adafruit/Adafruit-bq25185-with-3.3V-Buck-PCB/Adafruit bq25185 with 3.3V Output.brd

## EAGLE design Adafruit bq25185 with 3.3V Output.brd (2024-11-22)

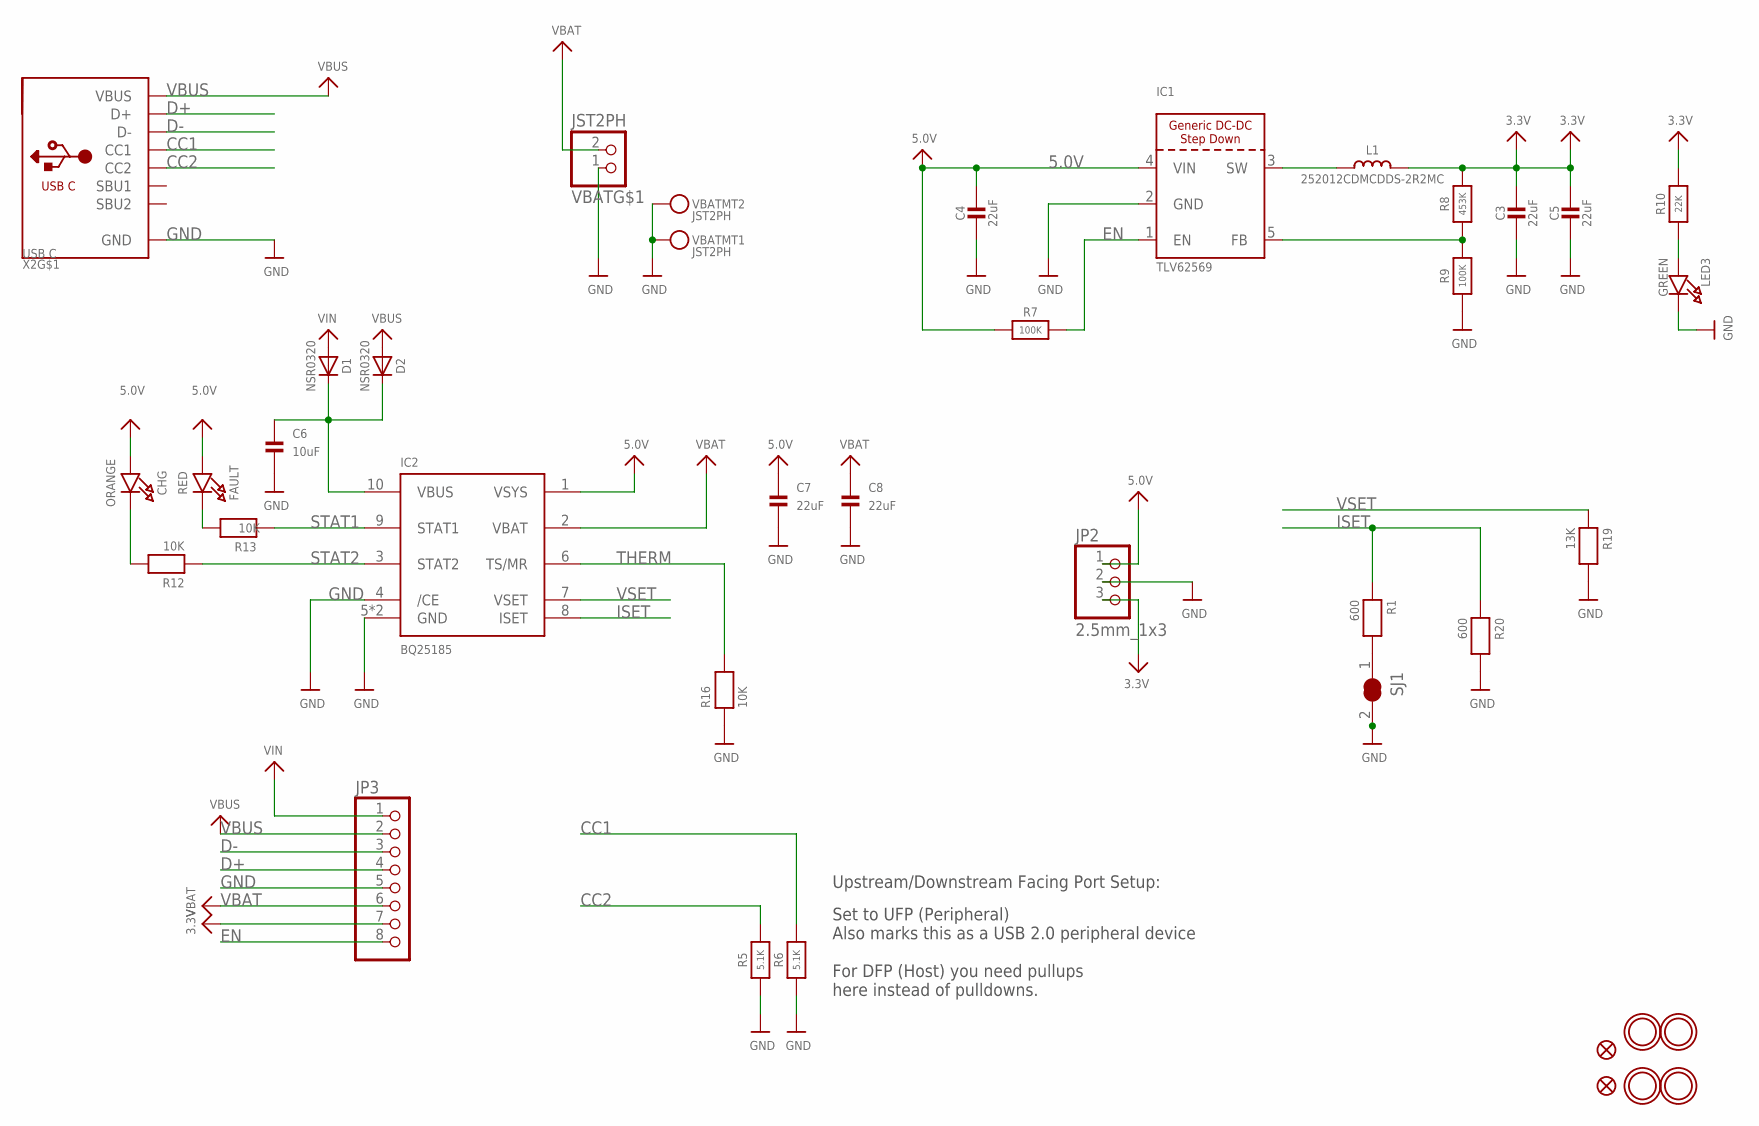
[picture p2: schematic Adafruit bq25185 with 3.3V Output.sch]

Parts:
C3, C4, C5, C7, C8: 22uF; 0805-NO
C6: 10uF; 0805-NO
CHG: ORANGE; CHIPLED_0603_NOOUTLINE
D1, D2: NSR0320; SOD-323_MINI
FAULT: RED; CHIPLED_0603_NOOUTLINE
FID1, FID2: FIDUCIAL_0.5MM
IC1: TLV62569; SOT23-5
IC2: BQ25185; WSON10
JP2: 2.5mm_1x3; 1X03_2.54MMTERMINAL
JP3: HEADER-1X870MIL; 1X08_ROUND_70
L1: 252012CDMCDDS-2R2MC; INDUCTOR_TAIYOYUDEN_NRH2412T
LED3: GREEN; CHIPLED_0603_NOOUTLINE
R1, R20: 600; _0402NO
R5, R6: 5.1K; _0402NO
R7, R9: 100K; _0402NO
R8: 453K; _0402NO
R10: 22K; _0402NO
R12, R13, R16: 10K; _0402NO
R19: 13K; _0402NO
SJ1: SOLDERJUMPER_CLOSED; SOLDERJUMPER_CLOSEDWIRE
U$9, U$10, U$11, U$12: MOUNTINGHOLE2.5; MOUNTINGHOLE_2.5_PLATED
VBAT: JST2PH; JSTPH2_BATT
X2: USB C; USB_C_CUSB31-CFM2AX-01-X

Connections:
3.3V: C3.1, C5.1, JP2.3, JP3.7, L1.2, R8.2, R10.2
5.0V: C4.1, C7.1, CHG.A, FAULT.A, IC1.4 (VIN), IC2.1 (VSYS), JP2.1, R7.1
CC1: R6.2, X2.A5 (CC1)
CC2: R5.2, X2.B5 (CC2)
D+: JP3.4, X2.A6 (D+), X2.B6 (D+)
D-: JP3.3, X2.A7 (D-), X2.B7 (D-)
EN: IC1.1 (EN), JP3.8, R7.2
FB: IC1.5 (FB), R8.1, R9.2
GND: C3.2, C4.2, C5.2, C6.2, C7.2, C8.2, IC1.2 (GND), IC2.4 (/CE), IC2.5 (GND), IC2.PAD (GND), JP2.2, JP3.5, LED3.C, R5.1, R6.1, R9.1, R16.1, R19.2, R20.2, SJ1.2, VBAT.1, VBAT.NC1, VBAT.NC2, X2.A1B12 (GND), X2.B1A12 (GND)
ISET: IC2.8 (ISET), R1.1, R20.1
unnamed: R1.2, SJ1.1
unnamed: C6.1, D1.C, D2.C, IC2.10 (VBUS)
unnamed: IC1.3 (SW), L1.1
unnamed: CHG.C, R12.2
unnamed: LED3.A, R10.1
unnamed: FAULT.C, R13.2
STAT1: IC2.9 (STAT1), R13.1
STAT2: IC2.3 (STAT2), R12.1
THERM: IC2.6 (TS/MR), R16.2
VBAT: C8.1, IC2.2 (VBAT), JP3.6, VBAT.2
VBUS: D2.A, JP3.2, X2.A4B9 (VBUS), X2.B4A9 (VBUS)
VIN: D1.A, JP3.1
VSET: IC2.7 (VSET), R19.1

Notes on the sheet:
Set to UFP (Peripheral) Also marks this as a USB 2.0 peripheral device For DFP (Host) you need pullups here instead of pulldowns.
Upstream/Downstream Facing Port Setup:

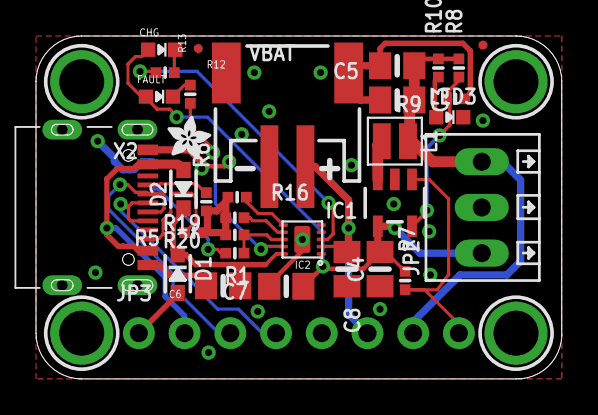
[picture p3: board Adafruit bq25185 with 3.3V Output.brd from above]

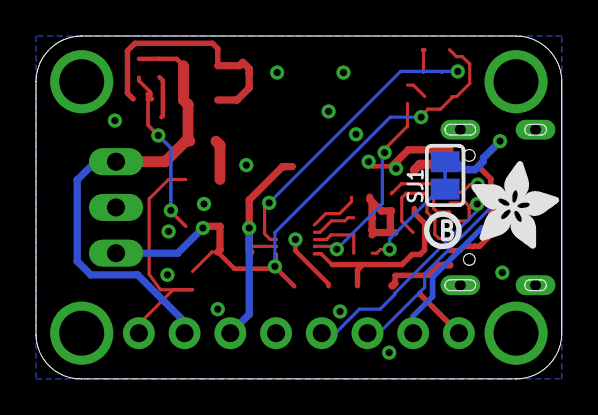
[picture p4: board Adafruit bq25185 with 3.3V Output.brd from below]

Board: 2 copper layers, 29.2 x 19.1 mm, 61 parts (11 on the bottom side), 23 nets.

Other parts of the board:
PLABEL0: PLABEL0
PLABEL1: PLABEL1
PLABEL2: PLABEL2
PLABEL3: PLABEL3
PLABEL4: PLABEL4
PLABEL5: PLABEL5
PLABEL6: PLABEL6
PLABEL7: PLABEL7
PLABEL8: PLABEL8
PLABEL9: PLABEL9
PLABEL10: PLABEL10
PLABEL11: PLABEL11
PLABEL12: PLABEL12
PLABEL13: PLABEL13
PLABEL14: PLABEL14
PLABEL15: PLABEL15
PLABEL16: PLABEL16
PLABEL17: PLABEL17
PLABEL18: PLABEL18
PLABEL19: PLABEL19
PLABEL20: PLABEL20
U$2: PCBFEAT-REV-040
U$26: ADAFRUIT_5MM
U$34: ADAFRUIT_2.5MM
